MasaoC/2026_higaeri/boards/higaeri.kicad_pcb

## KiCad design boards/higaeri.kicad_pcb (2026-06-16)

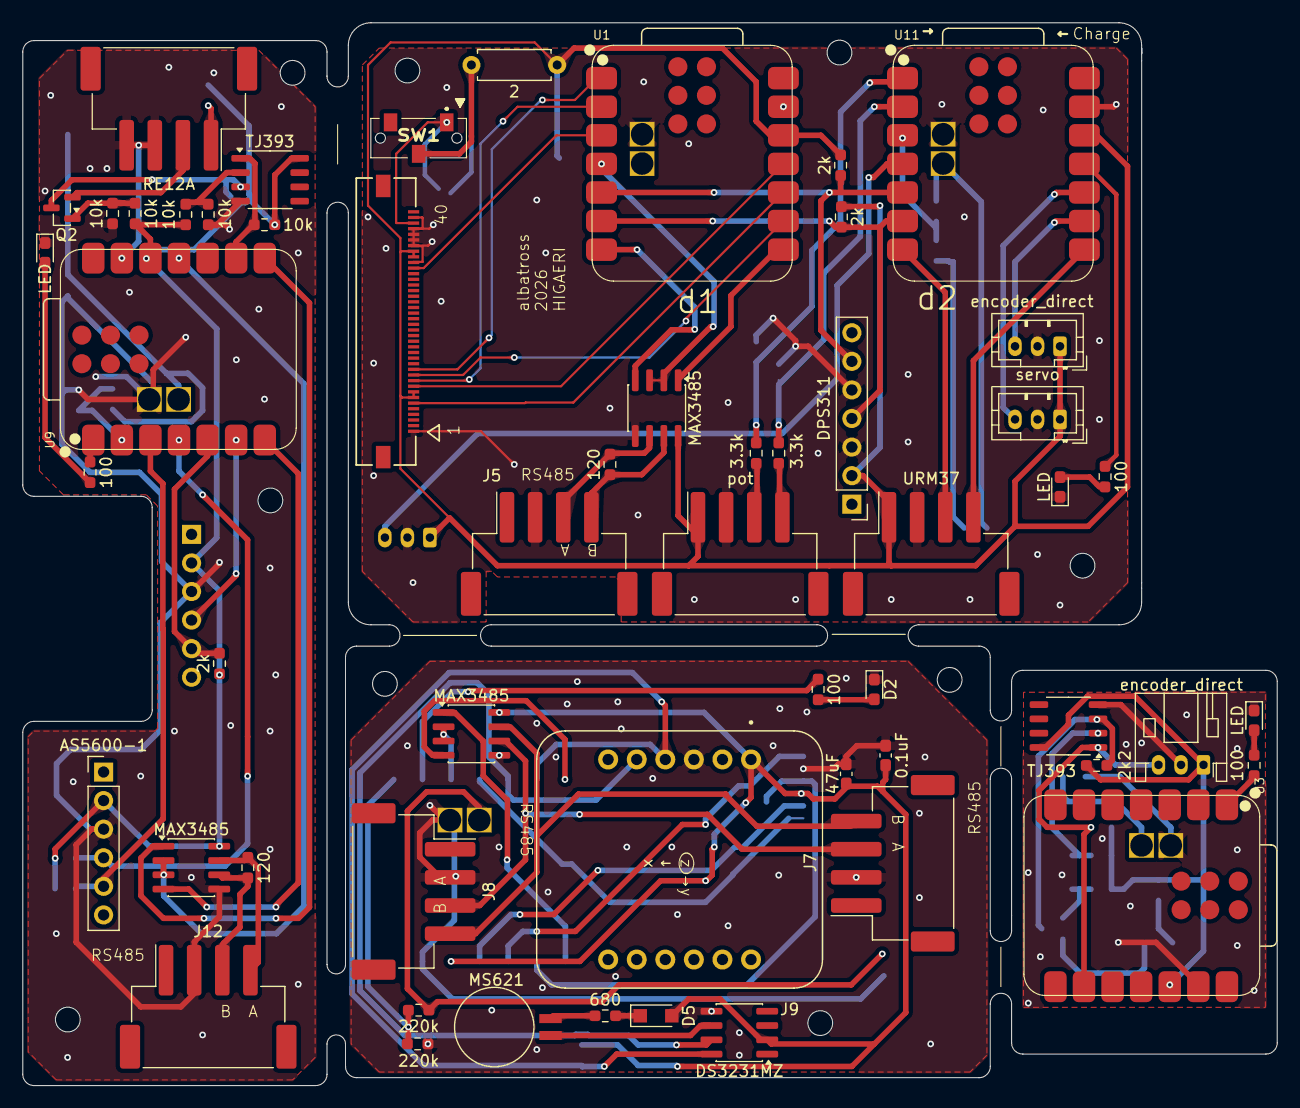
[picture p1: board higaeri.kicad_pcb from above]

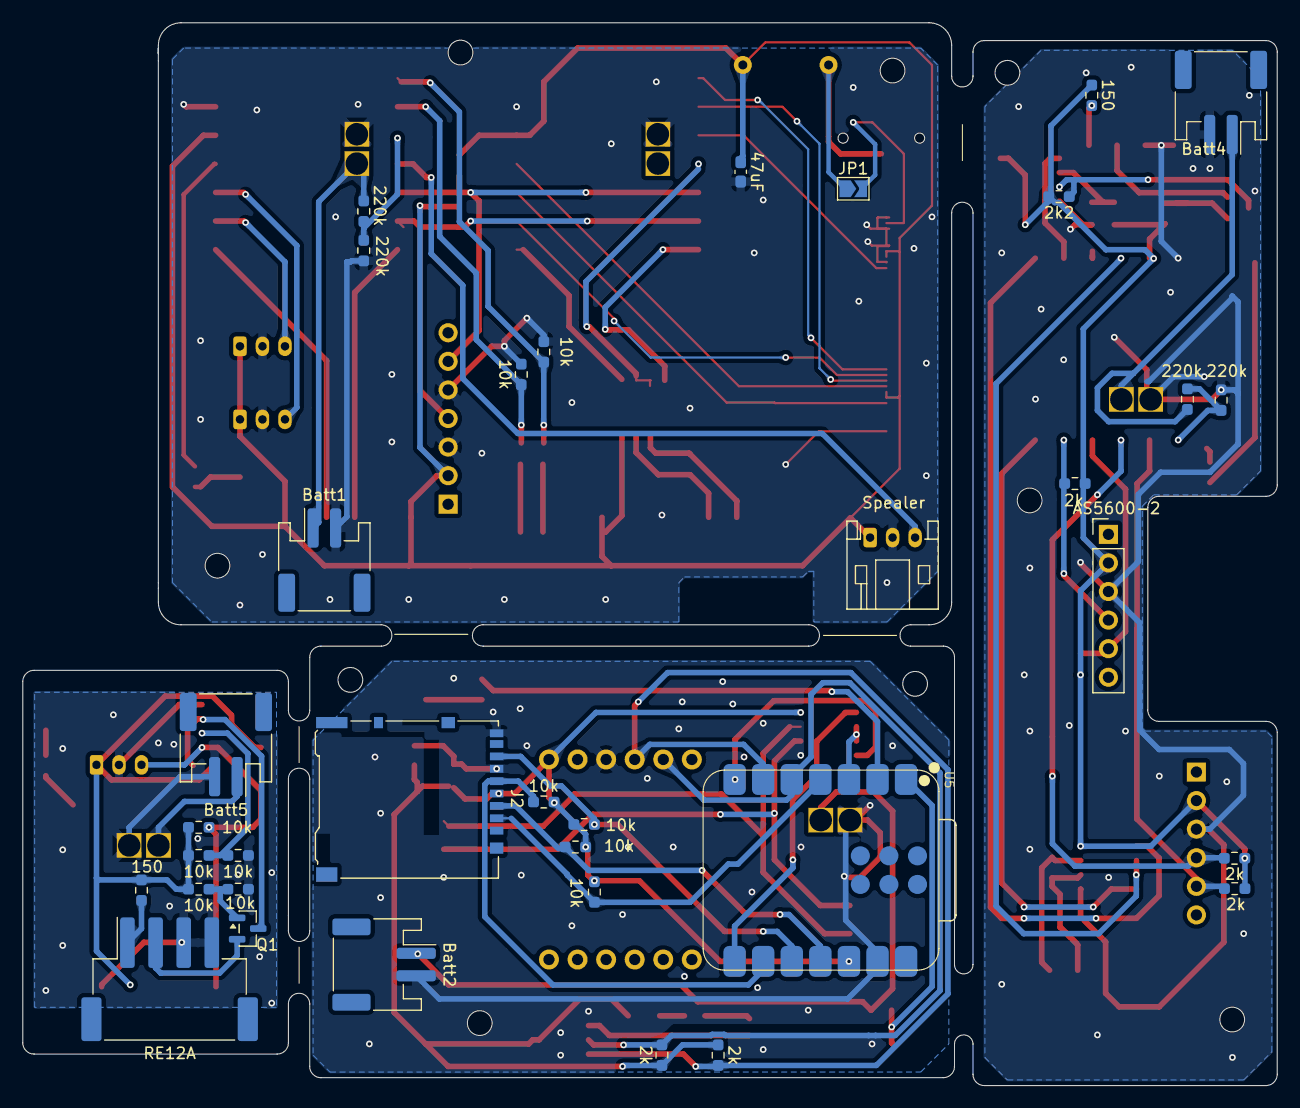
[picture p2: board higaeri.kicad_pcb from below]

Board: 2 copper layers, 111.5 x 94.4 mm, 90 parts (35 on the bottom side), 82 nets.

Parts:
AS5600-1: AoS; PinHeader_1x06_P2.54mm_Vertical
AS5600-2: AoA; PinHeader_1x06_P2.54mm_Vertical
BT2: MS621; BatteryHolder_Seiko_MS621F
Batt1, Batt2, Batt4, Batt5: Conn_01x02; JST_PH_S2B-PH-SM4-TB_1x02-1MP_P2.00mm_Horizontal
C1: 0.1uF; C_0603_1608Metric_Pad1.08x0.95mm_HandSolder
C2, C3: 47uF; C_0603_1608Metric_Pad1.08x0.95mm_HandSolder
D1, D2, D3, D4: LED; LED_0603_1608Metric_Pad1.05x0.95mm_HandSolder
D5: D; Nexperia_CFP3_SOD-123W
DPS311: Adafruit DPS310; PinHeader_1x07_P2.54mm_Vertical
J1: 5051104096; CON_5051104096_MOL
J2: Micro_SD_Card; microSD_HC_Hirose_DM3AT-SF-PEJM5
J3: URM37; JST_XH_S4B-XH-SM4-TB_1x04-1MP_P2.50mm_Horizontal
J4: servo; JST_PH_B3B-PH-K_1x03_P2.00mm_Vertical
J5: RS485_TFT; JST_XH_S4B-XH-SM4-TB_1x04-1MP_P2.50mm_Horizontal
J6: encoder_direct; JST_PH_B3B-PH-K_1x03_P2.00mm_Vertical
J7: RS485_logger_2; JST_XH_S4B-XH-SM4-TB_1x04-1MP_P2.50mm_Horizontal
J8: RS485_logger; JST_XH_S4B-XH-SM4-TB_1x04-1MP_P2.50mm_Horizontal
J9: BNO085; MODULE_4754_without_holes
J10: pot; JST_XH_S4B-XH-SM4-TB_1x04-1MP_P2.50mm_Horizontal
J11, J14: RE12A; JST_XH_S4B-XH-SM4-TB_1x04-1MP_P2.50mm_Horizontal
J12: RS485_airdata; JST_XH_S4B-XH-SM4-TB_1x04-1MP_P2.50mm_Horizontal
J13: Conn_01x03 speaker; JST_PH_S3B-PH-K_1x03_P2.00mm_Horizontal
J15: encoder_direct; JST_PH_S3B-PH-K_1x03_P2.00mm_Horizontal
JP1: SolderJumper_2_Open; SolderJumper-2_P1.3mm_Open_TrianglePad1.0x1.5mm
Q1, Q2: NPN; SOT-23
R1, R2, R3, R9, R13, R18, R19, R21, R37, R38, R40, R41, R42, R44, R45, R46: 10k; R_0603_1608Metric_Pad0.98x0.95mm_HandSolder
R4: 680; R_0603_1608Metric_Pad0.98x0.95mm_HandSolder
R5, R32: 120; R_0603_1608Metric_Pad0.98x0.95mm_HandSolder
R6, R7, R8, R11, R12, R14, R25, R27: 2k; R_0603_1608Metric_Pad0.98x0.95mm_HandSolder
R10, R20: 3.3k; R_0603_1608Metric_Pad0.98x0.95mm_HandSolder
R15, R22, R23, R31: 100; R_0603_1608Metric_Pad0.98x0.95mm_HandSolder
R16, R43: 2k2; R_0603_1608Metric_Pad0.98x0.95mm_HandSolder
R17: 2; R_Axial_DIN0207_L6.3mm_D2.5mm_P7.62mm_Horizontal
R24, R28, R33, R34, R35, R36: 220k; R_0603_1608Metric_Pad0.98x0.95mm_HandSolder
R26, R39: 150; R_0603_1608Metric_Pad0.98x0.95mm_HandSolder
SW1: SW_DIP_x01; CLSB12A02T
U1: MOUDLE-SEEEDUINO-XIAO-ESP32C3_TFT; XIAO-ESP32C3-SMD_battery_handsolder
U2, U4, U8: MAX3485; SOIC-8_3.9x4.9mm_P1.27mm
U3, U9: MOUDLE-SEEEDUINO-XIAO-ESP32C3_airdata; XIAO-ESP32C3-SMD_battery_handsolder
U5: MOUDLE-SEEEDUINO-XIAO-ESP32C3_logger; XIAO-ESP32C3-SMD_battery_handsolder
U6: DS3231MZ; SOIC-8_3.9x4.9mm_P1.27mm
U7, U10: TJ393; SOP-8_3.9x4.9mm_P1.27mm
U11: MOUDLE-SEEEDUINO-XIAO-ESP32C3_pot; XIAO-ESP32C3-SMD_battery_handsolder

Connections:
+3.3V-1: AS5600-1.2 (3V3), AS5600-2.2 (3V3), R6.1, R14.1, R25.1, R26.1, R27.1, R41.1, R43.1, R44.1, R46.1, U8.8 (VCC), U9.12 (3V3), U10.8 (V+)
+3.3V-2: C1.1, C2.1, D5.2 (A), J2.4 (VDD), J9.JP1_1 (VIN), R1.2, R2.2, R3.2, R7.1, R8.1, R13.2, U2.8 (VCC), U5.12 (3V3), U6.2 (VCC)
+3.3V-3: C3.1, DPS311.2 (3Vo), J1.7, J1.8, J1.32, J1.33, J3.1, J4.1, J6.1, J10.1, J13.1, R11.2, R12.1, R17.1, U1.12 (3V3), U4.8 (VCC), U11.12 (3V3)
+3.3V-4: J15.1, R16.1, R19.1, R37.1, R39.1, R40.1, U3.12 (3V3), U7.8 (V+)
+BATT-1: Batt4.1, R35.1, U9.15 (BAT)
+BATT-2: Batt2.1, R33.1, U5.15 (BAT)
+BATT-3: Batt1.1, R24.1, U11.15 (BAT)
+BATT-4: Batt5.1, U3.15 (BAT)
/1. airdata/DE/RE: U8.2 (~RE), U8.3 (DE), U9.11 (GPIO10_D10_MOSI)
/1. airdata/RS485_A: J12.3, R32.2, U8.6 (A)
/1. airdata/RS485_B: J12.4, R32.1, U8.7 (B)
/1. airdata/SCL: AS5600-2.4 (SCL), R6.2, U9.6 (GPIO7_D5_SCL)
/1. airdata/SCL_soft: AS5600-1.4 (SCL), R25.2, U9.4 (GPIO5_A3_D3)
/1. airdata/SDA: AS5600-2.5 (SDA), R14.2, U9.5 (GPIO6_D4_SDA)
/1. airdata/SDA_soft: AS5600-1.5 (SDA), R27.2, U9.3 (GPIO4_A2_D2)
/1. airdata/V_check-1: R35.2, R36.1, U9.2 (GPIO3_A1_D1)
/1. airdata/encoder_collector: J11.2, Q2.2 (E)
/1. airdata/encoder_out: R46.2, U9.9 (GPIO8_D8_SCK), U10.1
/1. airdata/input: Q2.3 (C), R43.2, U10.3 (+)
/2.logger/CS: J2.2 (DAT3/CD), R2.1, U5.4 (GPIO5_A3_D3)
/2.logger/DE/RE: U2.2 (~RE), U2.3 (DE), U5.3 (GPIO4_A2_D2)
/2.logger/MISO: J2.7 (DAT0), R3.1, U5.10 (GPIO9_D9_MISO)
/2.logger/MOSI: J2.3 (CMD), R1.1, U5.11 (GPIO10_D10_MOSI)
/2.logger/SCL: J9.JP1_4 (SCL), R8.2, U5.6 (GPIO7_D5_SCL), U6.8 (SCL)
/2.logger/SCLK: J2.5 (CLK), R13.1, U5.9 (GPIO8_D8_SCK)
/2.logger/SDA: J9.JP1_5 (SDA), R7.2, U5.5 (GPIO6_D4_SDA), U6.7 (SDA)
/2.logger/V_check-2: R33.2, R34.1, U5.1 (GPIO2_A0_D0)
/3. TFT/CS: J1.10, U1.2 (GPIO3_A1_D1)
/3. TFT/DCX-SCLK: J1.11, U1.9 (GPIO8_D8_SCK)
/3. TFT/DE/RE: U1.4 (GPIO5_A3_D3), U4.2 (~RE), U4.3 (DE)
/3. TFT/Pot_elv: R9.1, R10.1, U11.1 (GPIO2_A0_D0)
/3. TFT/Pot_rud: R18.1, R20.1, U11.2 (GPIO3_A1_D1)
/3. TFT/RES: J1.30, U1.3 (GPIO4_A2_D2)
/3. TFT/RS485_A: J5.3, R5.2, U4.6 (A)
/3. TFT/RS485_B: J5.4, R5.1, U4.7 (B)
/3. TFT/RX: J3.4, U11.8 (GPIO20_D7_RX)
/3. TFT/RX_encoder: J6.3, U11.9 (GPIO8_D8_SCK)
/3. TFT/SCL: DPS311.4 (SCK), R12.2, U1.6 (GPIO7_D5_SCL), U11.6 (GPIO7_D5_SCL)
/3. TFT/SDA: DPS311.6 (SDI), R11.1, U1.5 (GPIO6_D4_SDA), U11.5 (GPIO6_D4_SDA)
/3. TFT/SDA-MOSI: J1.9, U1.11 (GPIO10_D10_MOSI)
/3. TFT/SDO-MISO: J1.6, U1.10 (GPIO9_D9_MISO)
/3. TFT/Speaker: J13.3, U11.4 (GPIO5_A3_D3)
/3. TFT/TX: J3.3, U11.7 (GPIO21_D6_TX)
/3. TFT/V_check-3: R24.2, R28.1, U11.3 (GPIO4_A2_D2)
/3. TFT/WRX-D/C: J1.12, U1.1 (GPIO2_A0_D0)
/3. TFT/servo: J4.3, U11.10 (GPIO9_D9_MISO)
/RE12A_amplifier/encoder_anode: J14.1, R39.2
/RE12A_amplifier/encoder_collector: J14.2, Q1.2 (E)
/RE12A_amplifier/encoder_out: J15.3, R40.2, U3.9 (GPIO8_D8_SCK), U7.1
/RE12A_amplifier/input: Q1.3 (C), R16.2, U7.3 (+)
GND-1: AS5600-1.3 (GND), AS5600-2.3 (GND), Batt4.2, D4.1 (K), J11.3, J11.4, J12.2, R36.2, R42.2, R45.2, U8.5 (GND), U9.13 (GND), U9.16 (GND), U10.4 (V-)
GND-2: Batt2.2, C1.2, C2.2, D2.1 (K), J2.6 (VSS), J2.9 (SHIELD), J7.2, J8.2, J9.JP1_3 (GND), R34.2, U2.5 (GND), U5.13 (GND), U5.16 (GND), U6.5 (GND)
GND-3: Batt1.2, C3.2, D1.1 (K), DPS311.3 (GND), DPS311.5 (SDO), J1.1, J1.31, J1.34, J1.35, J1.36, J1.37, J1.39, J3.2, J4.2, J5.2, J6.2, J10.2, J13.2, R9.2, R18.2, R28.2, U1.13 (GND), U1.16 (GND), U4.5 (GND), U11.13 (GND), U11.16 (GND)
GND-4: Batt5.2, D3.1 (K), J14.3, J14.4, J15.2, R21.2, R38.2, U3.13 (GND), U3.16 (GND), U7.4 (V-)
unnamed: BT2.1 (+), R4.1
unnamed: BT2.2 (-), U6.6 (VBAT)
unnamed: D1.2 (A), R23.2
unnamed: D2.2 (A), R22.2
unnamed: D3.2 (A), R15.2
unnamed: D4.2 (A), R31.2
unnamed: D5.1 (K), R4.2
unnamed: J10.3, R10.2
unnamed: J10.4, R20.2
unnamed: J11.1, R26.2
unnamed: JP1.1 (A), R17.2, SW1.2
unnamed: J1.38, JP1.2 (B), SW1.1
unnamed: Q1.1 (B), R19.2, R21.1
unnamed: Q2.1 (B), R41.2, R42.1
unnamed: U1.8 (GPIO20_D7_RX), U4.1 (RO)
unnamed: U1.7 (GPIO21_D6_TX), U4.4 (DI)
unnamed: U2.4 (DI), U5.7 (GPIO21_D6_TX)
unnamed: U2.1 (RO), U5.8 (GPIO20_D7_RX)
unnamed: R15.1, U3.1 (GPIO2_A0_D0)
unnamed: R22.1, U5.2 (GPIO3_A1_D1)
unnamed: R37.2, R38.1, U7.2 (-)
unnamed: U8.4 (DI), U9.7 (GPIO21_D6_TX)
unnamed: U8.1 (RO), U9.8 (GPIO20_D7_RX)
unnamed: R31.1, U9.1 (GPIO2_A0_D0)
unnamed: R44.2, R45.1, U10.2 (-)
unnamed: R23.1, U11.11 (GPIO10_D10_MOSI)
RS485_A: J7.3, J8.3, U2.6 (A)
RS485_B: J7.4, J8.4, U2.7 (B)
