MasaoC/2026_higaeri/(commit log)

2026-06-13 高度計の補正以外完了
    [RE12A_amplifier.kicad_sch, TFTboard.kicad_sch, higaeri.kicad_pcb, higaeri.kicad_sch, loggerboard.kicad_sch, telemetry_20260606_064003.csv, untitled.kicad_sch]
2026-07-16 last TF
    [telemetry_20260704_044820.csv, telemetry_20260711_043746.csv, telemetry_20260711_043808.csv]
2026-07-24 2026本番
